toasterllc/MDCEnclosure/Desired-Finish.jpg

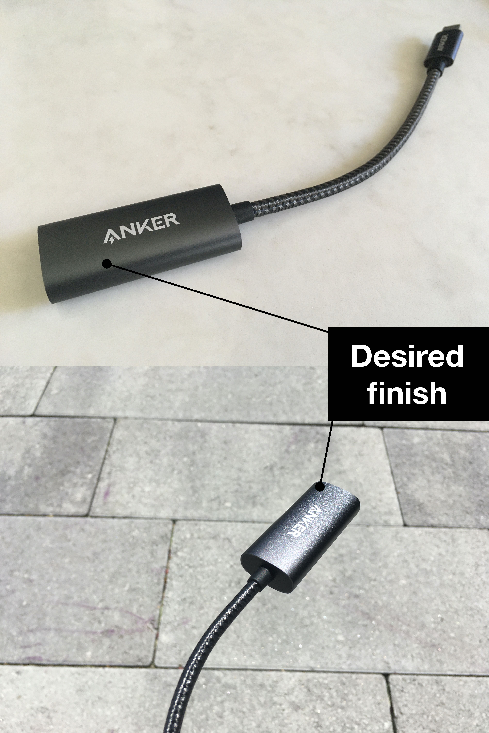
Desired-Finish.jpg
