toasterllc/MDCEnclosure/MDCEnclosure-Rev6/Requirements.pdf

## MDCEnclosure-Rev6 Requirements

## Questions: davekeck@gmail.com

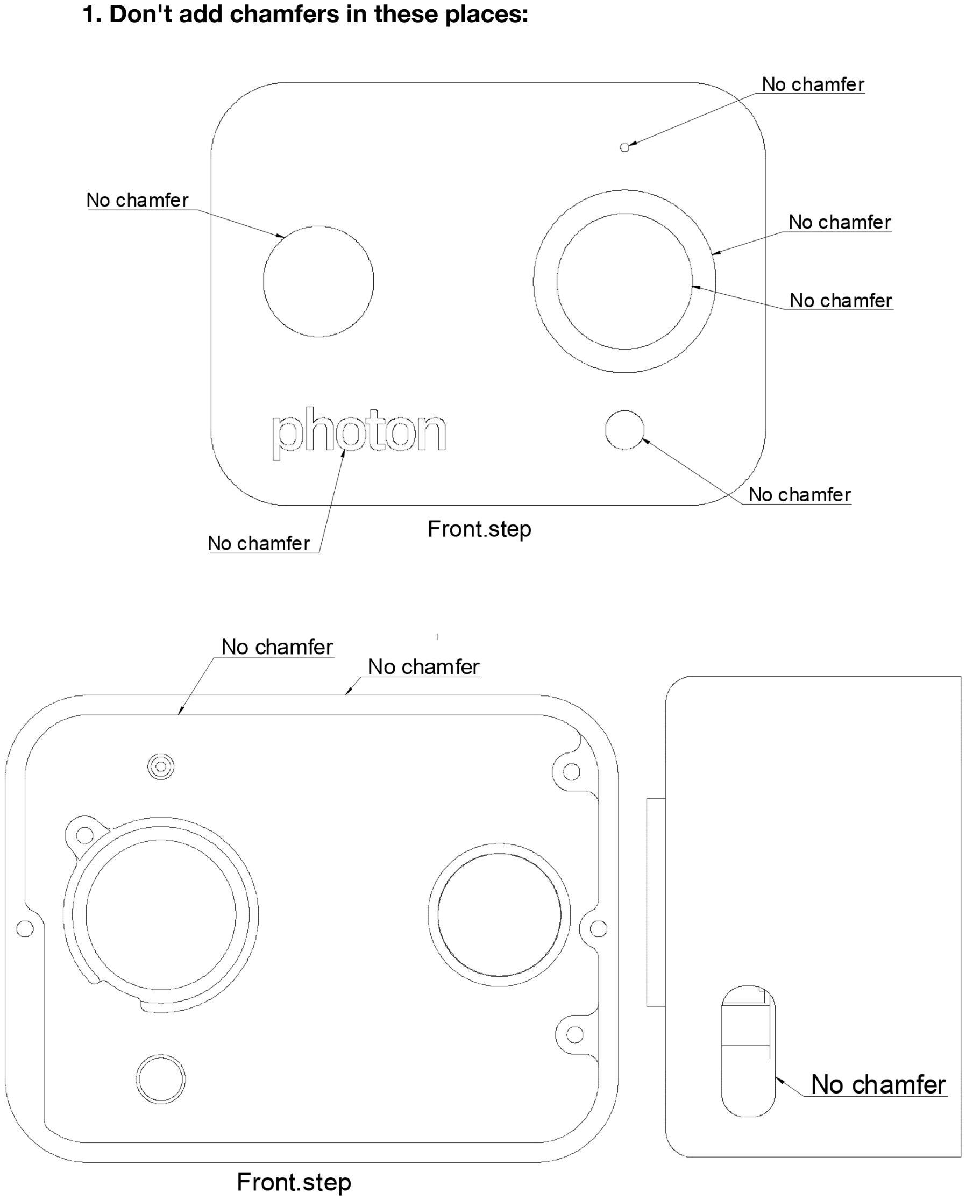
[picture p2: page 2]

### 1. Don't add chamfers in these places:

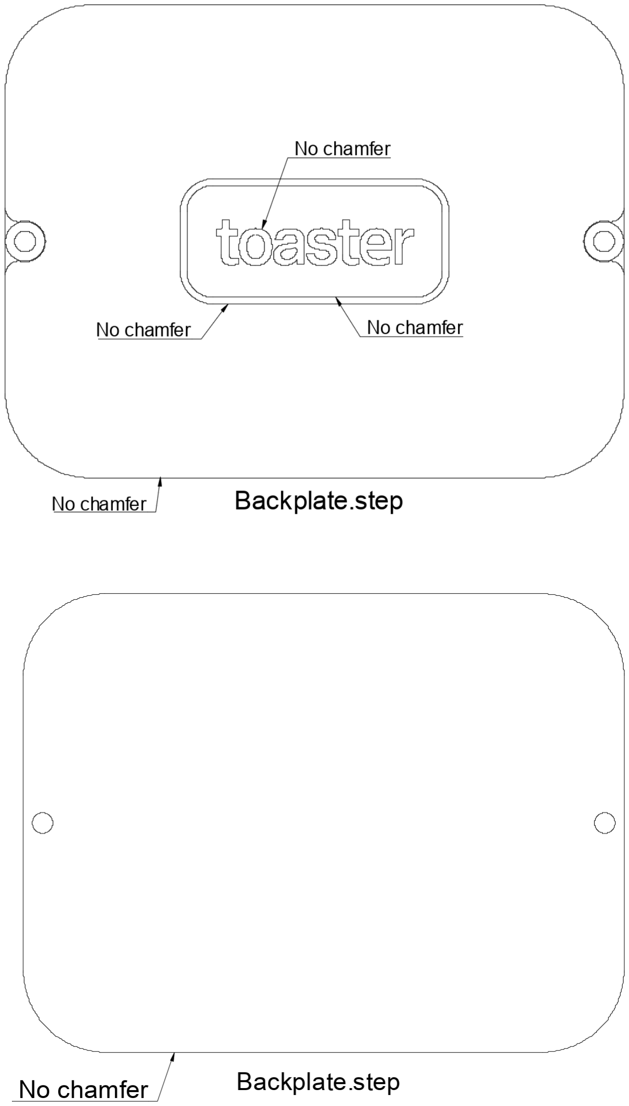
[picture p3: page 3]

### 2. The finish is very important for this order. Please match the color

and texture of the sample:

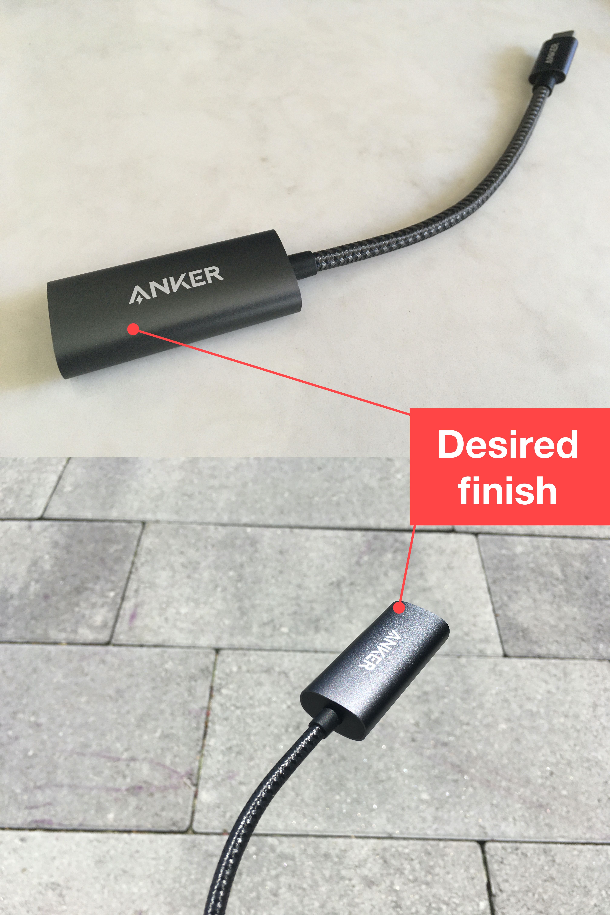
[picture p4: figure]
