toasterllc/MDCEnclosure/MDCEnclosure-Rev6/Button.step

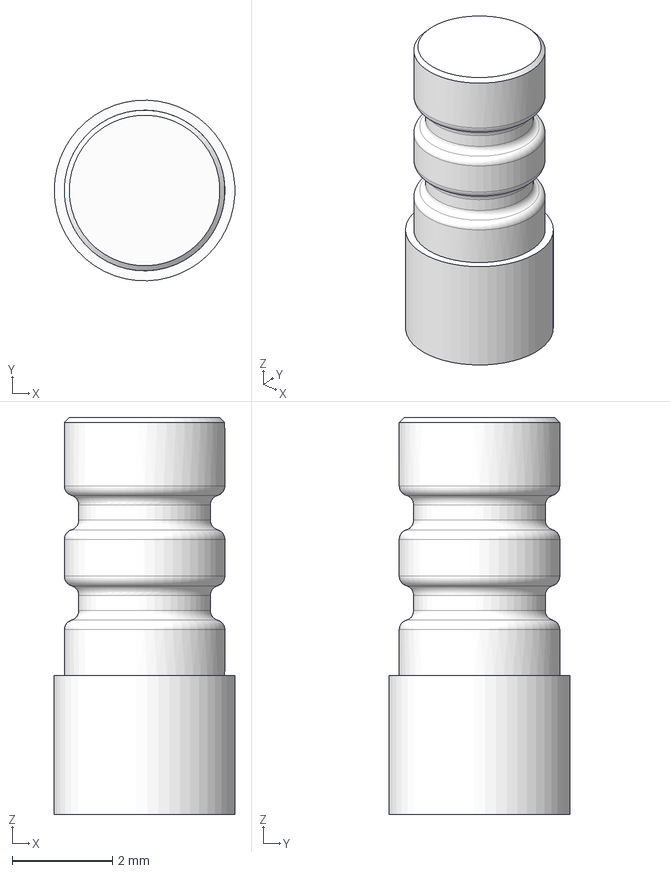
[picture p5: CAD file, 2023-07-13]
MDCEnclosure-Rev6/Button.step
3.60 x 3.60 x 7.91 mm
