toasterllc/MDCEnclosure/MDCEnclosure-Rev6/Front.step

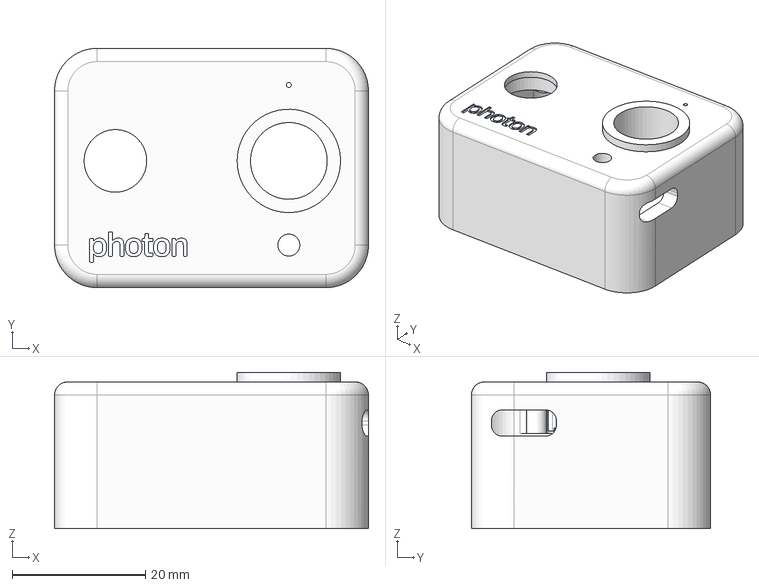
[picture p6: CAD file, 2023-07-13]
MDCEnclosure-Rev6/Front.step
47.2 x 35.9 x 23.5 mm
