toasterllc/MDCEnclosure/MDCEnclosure-Rev6/Backplate.step

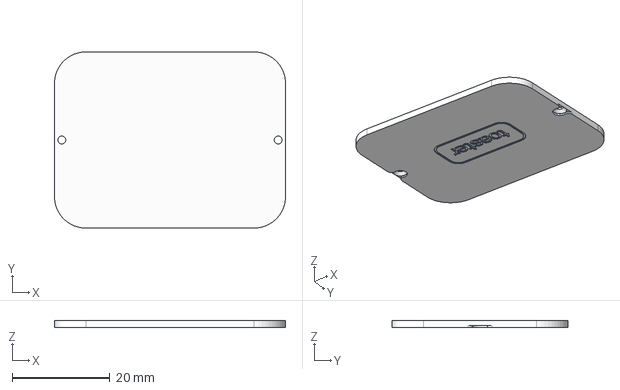
[picture p7: CAD file, 2023-07-13]
MDCEnclosure-Rev6/Backplate.step
47.2 x 35.9 x 1.50 mm
