toasterllc/MDCEnclosure/(list of files, cad)

Other CAD files:
MDCEnclosure.f3d
USB-C-Receptacle-Oring-Thickness.f3d
