toasterllc/MDCEnclosure/MDCEnclosure-Rev6/Front-Threads.pdf

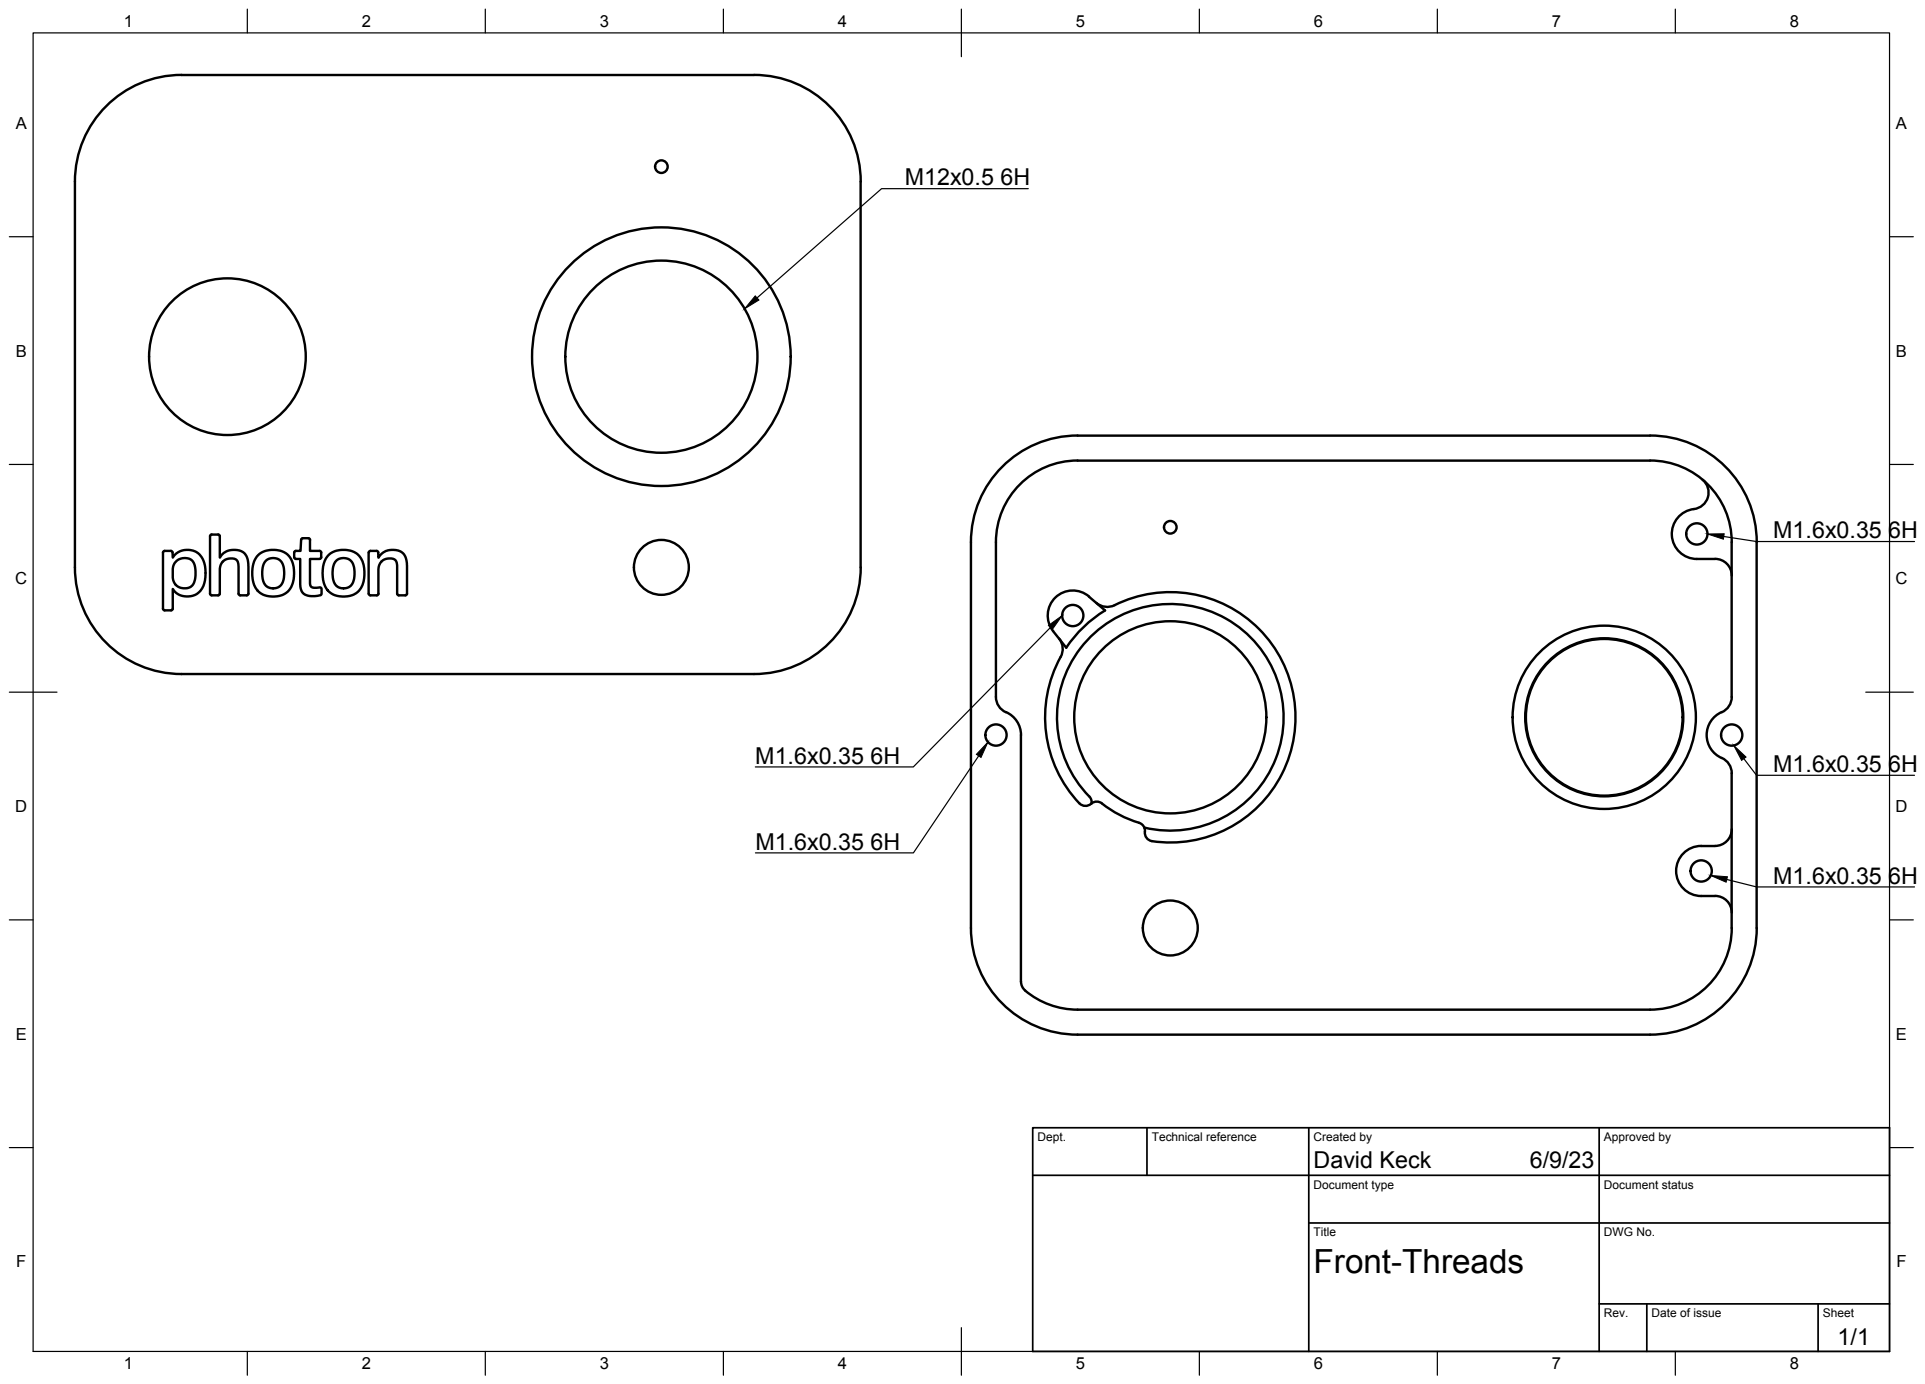
[picture p8: page 1]
Title; DWG No.; Rev.; Date of issue; Sheet

Dept. | Technical reference | Created by David Keck 6/9/23 | Approved by

Document type | Document status
