toasterllc/MDCEnclosure/(commit log)

2022-10-20 Add Rev1 Enclosure.f3d (from MDC repo enclosure/Rev1 tag)
    [Enclosure.f3d]
2022-10-21 Enclosure.f3d -> MDCEnclosure.f3d
    [MDCEnclosure.f3d]
2022-10-21 Started work on Rev2
    [MDCEnclosure.f3d]
2022-10-22 Rev2 progress
    [MDCEnclosure.f3d]
2022-10-23 Rev2 progress. Commit before investigating dovetail lid.
    [MDCEnclosure.f3d]
2022-10-24 Finished rough dovetail design. Probably need to fillet edges and tweak gaps to make a tight fit.
    [MDCEnclosure.f3d]
2022-10-24 Fillet dovetail edges
    [MDCEnclosure.f3d]
2022-10-24 Add logo to frontplate
    [MDCEnclosure.f3d]
2022-11-05 Commit before remaking MountPoints sketch
    [MDCEnclosure.f3d]
2022-11-05 Almost done remaking MointPoints sketch
    [MDCEnclosure.f3d]
2022-11-05 Fixed mount points
    [MDCEnclosure.f3d]
2022-11-05 Fix motion sensor hole diameter (the base of the motion sensor is 9.3mm, but we were previously using 10.4mm)
    [MDCEnclosure.f3d]
2022-11-05 Working on backplate indentation
    [MDCEnclosure.f3d]
2022-11-05 Added backplate fingernail indentation
    [MDCEnclosure.f3d]
2022-11-05 Make backplate gap smaller
    [MDCEnclosure.f3d]
2022-11-05 Improve backplate indent
    [MDCEnclosure.f3d]
2022-11-05 Update text font to use CriqueGrotesk-Medium
    [MDCEnclosure.f3d]
2022-11-05 Fix mount point radius
    [MDCEnclosure.f3d]
2022-11-05 Fix mount point radius, for real this time
    [MDCEnclosure.f3d]
2022-11-05 Adjust text logo
    [MDCEnclosure.f3d]
2022-11-07 Moved motion sensor so that its left-edge margin is the same as the lens' right-edge margin
    [MDCEnclosure.f3d]
2022-11-07 Started adding button
    [MDCEnclosure.f3d]
2022-11-07 Button progress
    [MDCEnclosure.f3d]
2022-11-07 Done adding button
    [MDCEnclosure.f3d]
2022-11-07 Add internal fillets to make internal edges smoother (to solve manufaturability warnings)
    [MDCEnclosure.f3d]
2022-11-18 Update tactile switch height
    [MDCEnclosure.f3d]
2022-11-20 Move toaster engraving to top face
    This commit is what we ordered from Shapeways
    [MDCEnclosure.f3d]
2022-11-20 Change appearance to be black
    [MDCEnclosure.f3d]
2022-11-24 Move toaster engraving to front face, so the 'up' direction is easily determined
    [MDCEnclosure.f3d]
2022-11-24 Tighten kerning on toaster engraving (exported SVG from Sketch)
    [MDCEnclosure.f3d]
2022-11-24 Cleanup (remove old ToasterText sketch)
    [MDCEnclosure.f3d]
2022-11-24 Move mount point location slightly to match MDCBoard
    [MDCEnclosure.f3d]
2022-11-24 Increase radius of front fillet to 2mm
    [MDCEnclosure.f3d]
2023-02-14 Switch tactile switch height 0.65 -> 0.60, since 0.60 seems more common
    [MDCEnclosure.f3d]
2023-02-14 Make button larger
    [MDCEnclosure.f3d]
2023-02-14 Make backplate fingernail indent larger
    [MDCEnclosure.f3d]
2023-02-14 Update LensThreadDepth = 9.2, intended for Caddx lens (C0PJ-TSZ02)
    [MDCEnclosure.f3d]
2023-02-14 Update lens socket thread offset: 2 -> 0.5 mm
    [MDCEnclosure.f3d]
2023-02-15 Fillet logo text corners
    [MDCEnclosure.f3d]
2023-05-19 Remove dovetail
    [MDCEnclosure.f3d]
2023-05-20 Backplate mount point progress
    [MDCEnclosure.f3d]
2023-05-21 Backplate progress
    [MDCEnclosure.f3d]
2023-05-21 Expand oring seat by .1mm so that oring seats easier
    [MDCEnclosure.f3d]
2023-05-21 Engraving text
    [MDCEnclosure.f3d]
2023-05-22 Commit before creating motion sensor
    [MDCEnclosure.f3d]
2023-05-22 Corrected motion sensor hole
    [MDCEnclosure.f3d]
2023-05-22 Update screw hole depths
    [MDCEnclosure.f3d]
2023-05-22 Move photon text slightly
    [MDCEnclosure.f3d]
2023-05-22 Working on board cutout
    [MDCEnclosure.f3d]
2023-05-23 Working on importing board outline
    [MDCEnclosure.f3d]
2023-05-23 Updated board object with new cutout profile
    [MDCEnclosure.f3d]
2023-05-23 Safety commit
    [MDCEnclosure.f3d]
2023-05-24 Update ButtonEnclosureClearance to make gap a little smaller around button: .2 -> .1 mm
    [MDCEnclosure.f3d]
2023-05-24 Correct backplate screw hole diameter (it was too small previously)
    [MDCEnclosure.f3d]
2023-05-24 Update board (after replacing board cutouts with a library device instead of manually drawing them on the board)
    [MDCEnclosure.f3d]
2023-05-25 Update board (we updated the board's cutout again to get the board outline layer working properly)
    [MDCEnclosure.f3d]
2023-05-25 Make board sketch edges colinear with origin xy edges
    [MDCEnclosure.f3d]
2023-05-29 Add USB-C receptacle (GT-USB-7030A)
    [MDCEnclosure.f3d]
2023-05-29 Fix USB-C receptacle position
    [MDCEnclosure.f3d]
2023-05-29 Progress working on waterproof USB-C receptacle
    [MDCEnclosure.f3d]
2023-05-29 Update USB-C enclosure cutout for new USB-C receptacle
    [MDCEnclosure.f3d]
2023-05-29 USB-C cutout
    [MDCEnclosure.f3d]
2023-05-30 Update board profile
    [MDCEnclosure.f3d]
2023-06-03 Motion sensor o-ring progress
    [MDCEnclosure.f3d]
2023-06-03 Add lens oring
    [MDCEnclosure.f3d]
2023-06-03 Fix oring move features
    [MDCEnclosure.f3d]
2023-06-03 Commit before adding orings to button
    [MDCEnclosure.f3d]
2023-06-03 Add oring seats to button
    [MDCEnclosure.f3d]
2023-06-03 Add orings to button
    [MDCEnclosure.f3d]
2023-06-03 Fix lens oring seat depth
    [MDCEnclosure.f3d]
2023-06-03 Backplate gasket progress
    [MDCEnclosure.f3d]
2023-06-04 Fix fillets
    [MDCEnclosure.f3d]
2023-06-04 Finished backplate gasket
    [MDCEnclosure.f3d]
2023-06-04 Fix frontplate thickness so USB-C receptacle cutout doesn't intersect it
    [MDCEnclosure.f3d]
2023-06-04 Fix fillet that resulted in a too-small gap
    [MDCEnclosure.f3d]
2023-06-04 Add chamfer to button
    [MDCEnclosure.f3d]
2023-06-04 Update button oring dimensions
    [MDCEnclosure.f3d]
2023-06-04 Correct USB-C receptacle width/height based on receptacle datasheet. Need to verify that receptacle has enough clearance...
    [MDCEnclosure.f3d]
2023-06-04 Improve interior lens protrusion cutout to accomodate USB-C receptacle installation
    [MDCEnclosure.f3d]
2023-06-04 Figure out best angles for interior lens protrusion cutout to accomodate USB-C receptacle
    [MDCEnclosure.f3d]
2023-06-04 Add a bit more USB-C receptacle clearance on interior lens protrusion
    [MDCEnclosure.f3d]
2023-06-05 Update board after fixing DRC errors
    [MDCEnclosure.f3d]
2023-06-05 Make button orings a separate component so we can confidently export the button without the orings being included
    [MDCEnclosure.f3d]
2023-06-05 Update backplate text fillet
    [MDCEnclosure.f3d]
2023-06-08 Add MDCEnclosure-Rev4.zip / MDCEnclosure-Rev4
    [Backplate.step, Button.step, Front.step]
2023-06-08 Update animation to prevent contact between USB-C receptacle and enclosure
    [MDCEnclosure.f3d]
2023-06-08 Reduce height of mount point 3 to provide clearance for board installation
    [MDCEnclosure.f3d]
2023-06-08 Exported MDCEnclosure-Rev4 files, update MDCEnclosure-Rev4.zip
    [Backplate.step, Button.step, Front.step, MDCEnclosure.f3d]
2023-06-08 Moved mount point 3 to give board clearance for installation
    [MDCEnclosure.f3d]
2023-06-09 Updated MDCEnclosure-Rev4 files
    [Backplate.step, Button.step, Front.step, MDCEnclosure.f3d]
2023-06-12 Rename to rev5 to avoid confusion, after moving mount point #3
    [Backplate.step, Button.step, Front.step]
2023-07-01 Remove ledge near USB-C hole
    [MDCEnclosure.f3d]
2023-07-01 Add USB-C-Receptacle-Oring-Thickness.f3d
    [USB-C-Receptacle-Oring-Thickness.f3d]
2023-07-01 Remove one of the button o-rings
    [MDCEnclosure.f3d]
2023-07-01 Adjust button length so that it protrudes more, and accounts for: 1. tactile switch height variances, and 2. tactile switch elevation due to soldering
    [MDCEnclosure.f3d]
2023-07-01 Add recess to backplate screw holes so that screws rest flush with backplate
    [MDCEnclosure.f3d]
2023-07-01 Backplate: make engraving rect an outline instead of a fully-recessed region
    [MDCEnclosure.f3d]
2023-07-01 Backplate: adjust text position
    [MDCEnclosure.f3d]
2023-07-02 Front: initial LED recess implementation
    [MDCEnclosure.f3d]
2023-07-03 Front: update LED recess
    [MDCEnclosure.f3d]
2023-07-03 Backplate: remove gasket recess
    [MDCEnclosure.f3d]
2023-07-03 Front: add chamfer to interior side of button hole to facilitate oring insertion
    [MDCEnclosure.f3d]
2023-07-03 Move button hole chamfer feature to Front group
    [MDCEnclosure.f3d]
2023-07-03 Update board outline from Eagle outline
    [MDCEnclosure.f3d]
2023-07-10 Update LED hole for latest waterproofing strategy
    [MDCEnclosure.f3d]
2023-07-13 Make LED hole parameterized on LED fiber diameter
    [MDCEnclosure.f3d]
2023-07-13 Add 2nd oring back to button, in case we decide we want 2 in the future
    [MDCEnclosure.f3d]
2023-07-13 Add MDCEnclosure-Rev6 zip directory
    [Backplate.step, Button.step, Front.step, MDCEnclosure.f3d]
